aauer1/sam9g25/sam9g25.sch.pdf

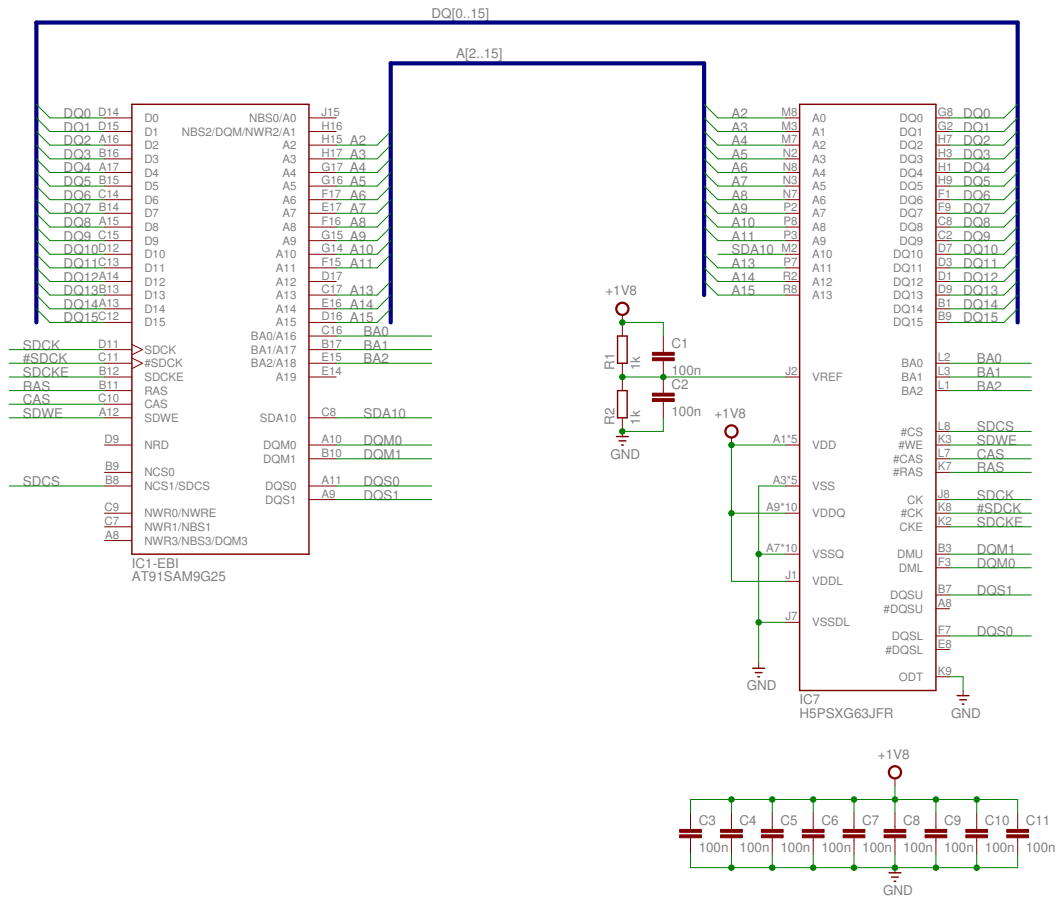
[picture p1: page 1]

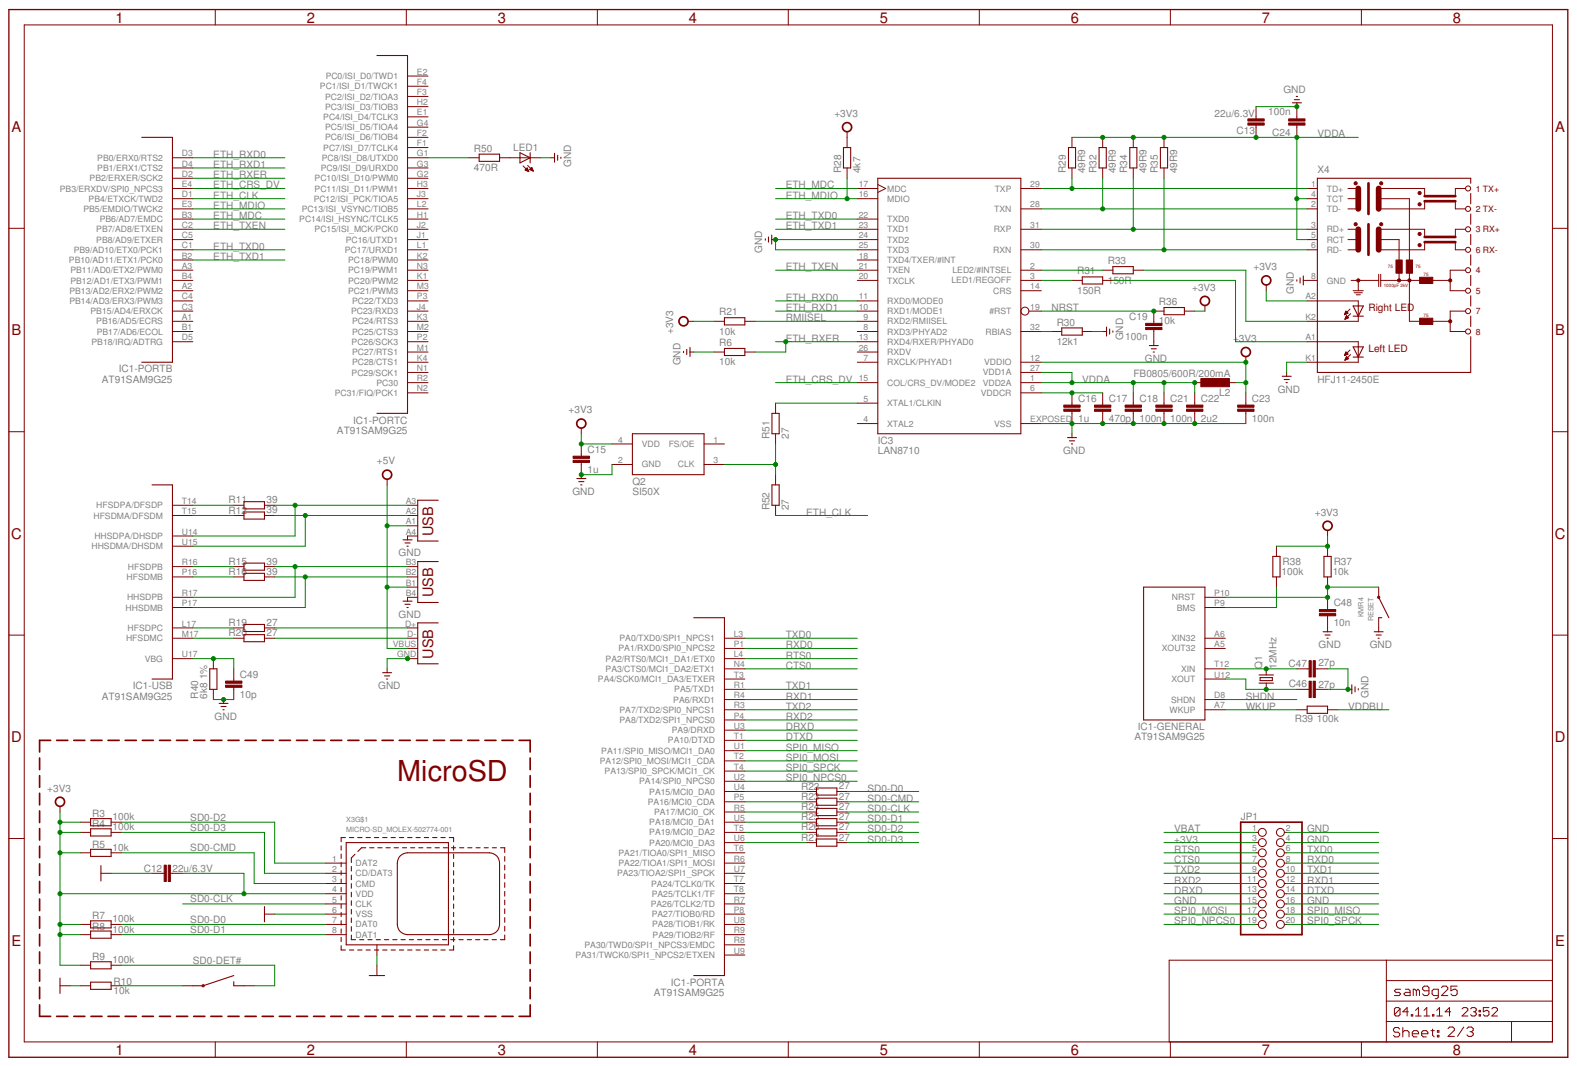
[picture p2: page 2]

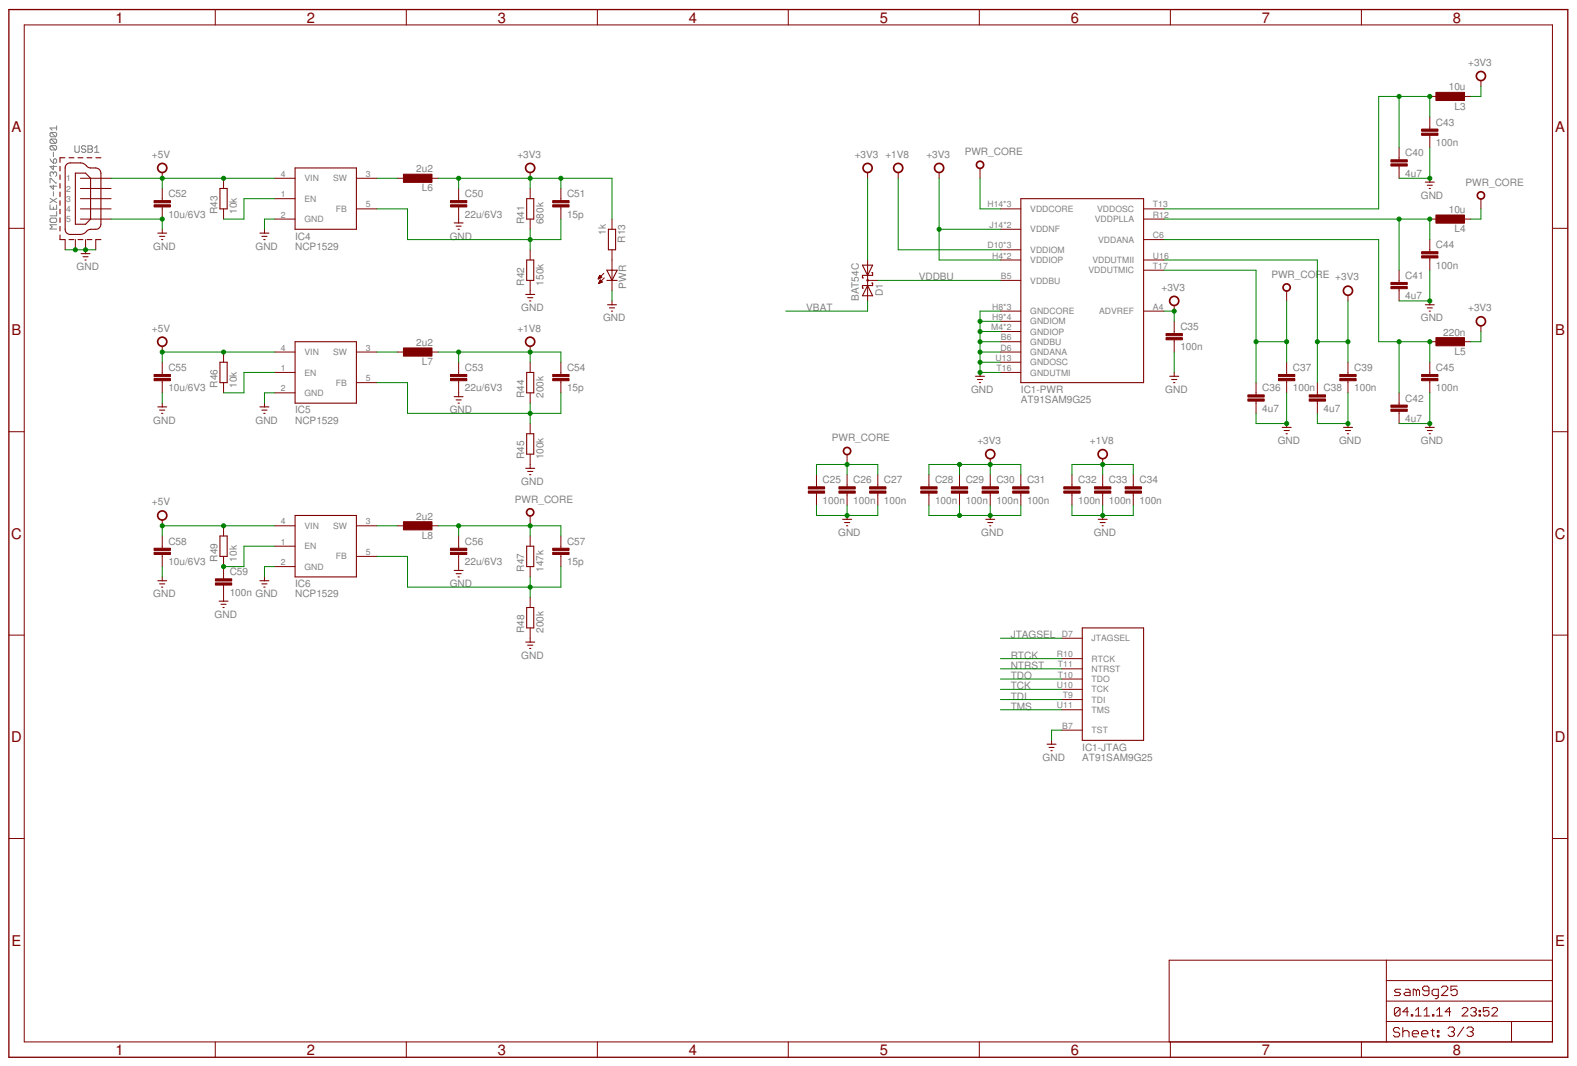
[picture p3: page 3]
