aauer1/sam9g25/sam9g25.brd

## EAGLE design sam9g25.brd (2015-02-23)

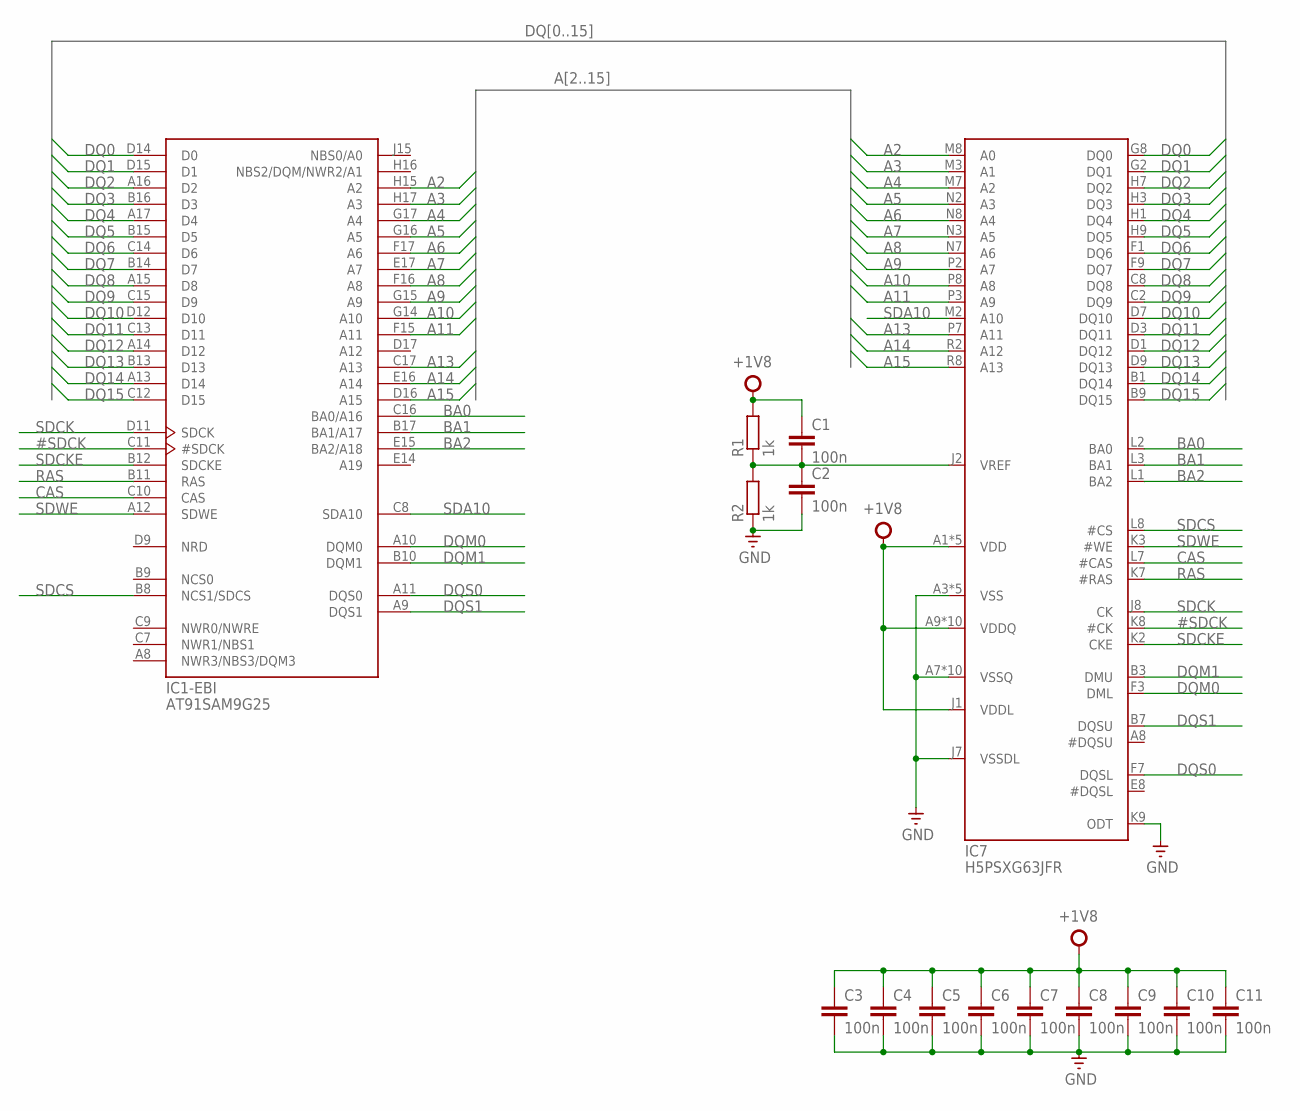
[picture p4: schematic sam9g25.sch, sheet 1]

Parts:
C1, C2, C3, C4, C5, C6, C7, C8, C9, C10, C11: 100n; C0603; MPN MC0603B104K250CT
IC1: AT91SAM9G25; LFBGA217; MPN AT91SAM9G25-CU
IC7: H5PSXG63JFR; FBGA84; MPN H5PS1G63JFR-S5C
R1, R2: 1k; R0603; MPN MC0063W060351K5

Connections:
#SDCK: IC1.C11 (#SDCK), IC7.K8 (#CK)
+1V8: C1.1, C3.1, C4.1, C5.1, C6.1, C7.1, C8.1, C9.1, C10.1, C11.1, IC7.A1 (VDD), IC7.A9 (VDDQ), IC7.C1 (VDDQ), IC7.C3 (VDDQ), IC7.C7 (VDDQ), IC7.C9 (VDDQ), IC7.E1 (VDD), IC7.E9 (VDDQ), IC7.G1 (VDDQ), IC7.G3 (VDDQ), IC7.G7 (VDDQ), IC7.G9 (VDDQ), IC7.J1 (VDDL), IC7.J9 (VDD), IC7.M9 (VDD), IC7.R1 (VDD), R1.2; also elsewhere on the board
A2: IC1.H15 (A2), IC7.M8 (A0)
A3: IC1.H17 (A3), IC7.M3 (A1)
A4: IC1.G17 (A4), IC7.M7 (A2)
A5: IC1.G16 (A5), IC7.N2 (A3)
A6: IC1.F17 (A6), IC7.N8 (A4)
A7: IC1.E17 (A7), IC7.N3 (A5)
A8: IC1.F16 (A8), IC7.N7 (A6)
A9: IC1.G15 (A9), IC7.P2 (A7)
A10: IC1.G14 (A10), IC7.P8 (A8)
A11: IC1.F15 (A11), IC7.P3 (A9)
A13: IC1.C17 (A13), IC7.P7 (A11)
A14: IC1.E16 (A14), IC7.R2 (A12)
A15: IC1.D16 (A15), IC7.R8 (A13)
BA0: IC1.C16 (BA0/A16), IC7.L2 (BA0)
BA1: IC1.B17 (BA1/A17), IC7.L3 (BA1)
BA2: IC1.E15 (BA2/A18), IC7.L1 (BA2)
CAS: IC1.C10 (CAS), IC7.L7 (#CAS)
DQ0: IC1.D14 (D0), IC7.G8 (DQ0)
DQ1: IC1.D15 (D1), IC7.G2 (DQ1)
DQ2: IC1.A16 (D2), IC7.H7 (DQ2)
DQ3: IC1.B16 (D3), IC7.H3 (DQ3)
DQ4: IC1.A17 (D4), IC7.H1 (DQ4)
DQ5: IC1.B15 (D5), IC7.H9 (DQ5)
DQ6: IC1.C14 (D6), IC7.F1 (DQ6)
DQ7: IC1.B14 (D7), IC7.F9 (DQ7)
DQ8: IC1.A15 (D8), IC7.C8 (DQ8)
DQ9: IC1.C15 (D9), IC7.C2 (DQ9)
DQ10: IC1.D12 (D10), IC7.D7 (DQ10)
DQ11: IC1.C13 (D11), IC7.D3 (DQ11)
DQ12: IC1.A14 (D12), IC7.D1 (DQ12)
DQ13: IC1.B13 (D13), IC7.D9 (DQ13)
DQ14: IC1.A13 (D14), IC7.B1 (DQ14)
DQ15: IC1.C12 (D15), IC7.B9 (DQ15)
DQM0: IC1.A10 (DQM0), IC7.F3 (DML)
DQM1: IC1.B10 (DQM1), IC7.B3 (DMU)
DQS0: IC1.A11 (DQS0), IC7.F7 (DQSL)
DQS1: IC1.A9 (DQS1), IC7.B7 (DQSU)
GND: C2.2, C3.2, C4.2, C5.2, C6.2, C7.2, C8.2, C9.2, C10.2, C11.2, IC7.A3 (VSS), IC7.A7 (VSSQ), IC7.B2 (VSSQ), IC7.B8 (VSSQ), IC7.D2 (VSSQ), IC7.D8 (VSSQ), IC7.E3 (VSS), IC7.E7 (VSSQ), IC7.F2 (VSSQ), IC7.F8 (VSSQ), IC7.H2 (VSSQ), IC7.H8 (VSSQ), IC7.J3 (VSS), IC7.J7 (VSSDL), IC7.K9 (ODT), IC7.N1 (VSS), IC7.P9 (VSS), R2.1; also elsewhere on the board
unnamed: C1.2, C2.1, IC7.J2 (VREF), R1.1, R2.2
RAS: IC1.B11 (RAS), IC7.K7 (#RAS)
SDA10: IC1.C8 (SDA10), IC7.M2 (A10)
SDCK: IC1.D11 (SDCK), IC7.J8 (CK)
SDCKE: IC1.B12 (SDCKE), IC7.K2 (CKE)
SDCS: IC1.B8 (NCS1/SDCS), IC7.L8 (#CS)
SDWE: IC1.A12 (SDWE), IC7.K3 (#WE)

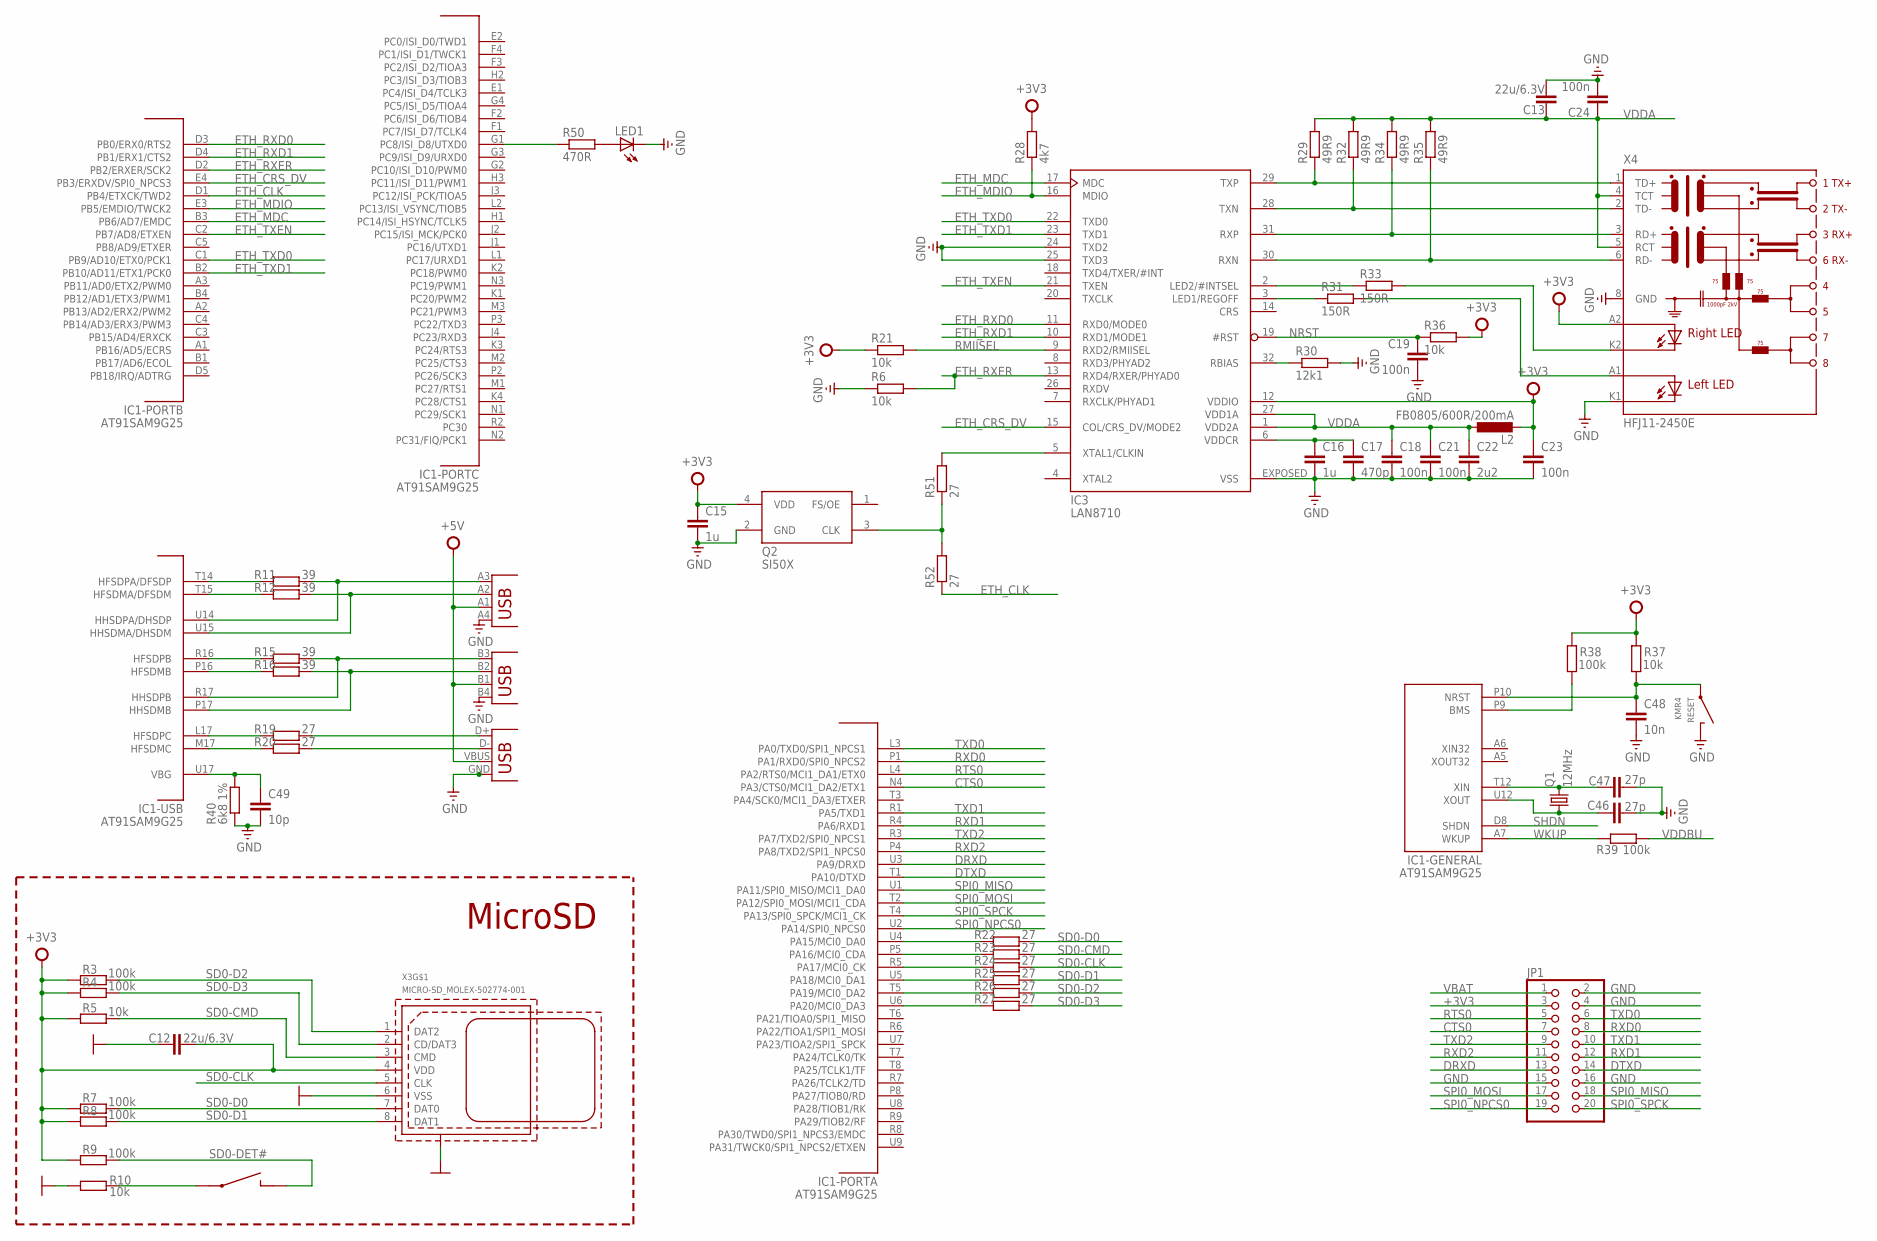
[picture p5: schematic sam9g25.sch, sheet 2]

Parts:
C12, C13: 22u/6.3V; C0805; MPN C2012X5R0J226M/1.25
C15: 1u; C0603; MPN MC0603N270J500CT
C16: 1u; C0603; MPN MC0603X105K100CT
C17: 470p; C0603; MPN MC0603B471K500CT
C18, C19, C21, C23, C24: 100n; C0603; MPN MC0603B104K250CT
C22: 2u2; C0603; MPN MC0603X225K6R3CT
C46, C47: 27p; C0603; MPN MC0603N270J500CT
C48: 10n; C0603; MPN MC0603B103K160CT
C49: 10p; C0603; MPN MC0603N100J500CT
IC1: AT91SAM9G25; LFBGA217; MPN AT91SAM9G25-CU
IC3: LAN8710; QFN32; MPN LAN8710A-EZK
JP1: PINHD-2X10; 2X10
L2: FB0805/600R/200mA; L2012C; MPN BLM21BD601SN1D
LED1: LEDCHIP-LED0603; CHIP-LED0603; MPN KP-1608SURCK
Q1: 12MHz; SMD5032; MPN 7A-12.000MAAJ-T
Q2: SI50X; DFN4
R3, R4, R7, R8, R9, R38, R39: 100k; R0603; MPN MC0063W06035100K
R5, R6, R10, R21, R37: 10k; R0603; MPN RC0603FR-0710KL
R11, R12, R15, R16: 39; R0603; MPN CRCW060339R0FKEA
R19, R20, R22, R23, R24, R25, R26, R27: 27; R0603; MPN MC0063W0603527R
R28: 4k7; R0603; MPN MC0063W060354K7
R29, R32, R34, R35: 49R9; R0603; MPN ERJ3GEYJ510V
R30: 12k1; R0603; MPN ERJ3EKF1212V
R31, R33: 150R; R0603; MPN MC0063W06035150R
R36: 10k; R0603; MPN ERJ3EKF1212V
R40: 6k8 1%; R0603; MPN MCMR06X6801FTL
R50: 470R; R0603; MPN MCMR06X1001FTL
R51, R52: 27; R0603; MPN RC0603FR-0710KL
RESET: KMR4; MPN KMR421NGULCLFS
X1: USB-DOUBLE; USB-DOUBLE-FCI; MPN 72309-8034BLF
X3: MICRO-SD_MOLEX-502774-001; MOLEX-MICRO-SD; MPN 502774-0891
X4: HFJ11-2450E; HFJ11_LED
X5: USB-A-HU

Connections:
+3V3: C12.2, C15.1, C23.1, IC3.12 (VDDIO), JP1.3, L2.2, Q2.4 (VDD), R3.2, R4.2, R5.2, R7.2, R8.2, R9.2, R21.1, R28.2, R36.2, R37.2, R38.2, X3.4 (VDD), X4.A2 (A-R); also elsewhere on the board
+5V: X1.A1 (VBUS), X1.B1 (VBUS), X5.VBUS; also elsewhere on the board
CTS0: IC1.N4 (PA3/CTS0/MCI1_DA2/ETX1), JP1.7
DRXD: IC1.U3 (PA9/DRXD), JP1.13
DTXD: IC1.T1 (PA10/DTXD), JP1.14
ETH_CLK: IC1.D1 (PB4/ETXCK/TWD2), R52.1
ETH_CRS_DV: IC1.E4 (PB3/ERXDV/SPI0_NPCS3), IC3.15 (COL/CRS_DV/MODE2)
ETH_MDC: IC1.B3 (PB6/AD7/EMDC), IC3.17 (MDC)
ETH_MDIO: IC1.E3 (PB5/EMDIO/TWCK2), IC3.16 (MDIO), R28.1
ETH_RXD0: IC1.D3 (PB0/ERX0/RTS2), IC3.11 (RXD0/MODE0)
ETH_RXD1: IC1.D4 (PB1/ERX1/CTS2), IC3.10 (RXD1/MODE1)
ETH_RXER: IC1.D2 (PB2/ERXER/SCK2), IC3.13 (RXD4/RXER/PHYAD0), R6.2
ETH_TXD0: IC1.C1 (PB9/AD10/ETX0/PCK1), IC3.22 (TXD0)
ETH_TXD1: IC1.B2 (PB10/AD11/ETX1/PCK0), IC3.23 (TXD1)
ETH_TXEN: IC1.C2 (PB7/AD8/ETXEN), IC3.21 (TXEN)
GND: C12.1, C13.2, C15.2, C16.2, C17.2, C18.2, C19.2, C21.2, C22.2, C23.2, C24.2, C46.2, C47.2, C48.2, C49.2, IC3.24 (TXD2), IC3.25 (TXD3), IC3.EXPOSED (VSS), JP1.2, JP1.4, JP1.15, JP1.16, LED1.C, Q2.2 (GND), R6.1, R10.2, R30.2, R40.1, RESET.2, RESET.4, X1.A4 (GND), X1.B4 (GND), X3.6 (VSS), X3.SHIELD@1, X3.SHIELD@2, X3.SHIELD@3, X3.SHIELD@4, X4.8 (GND), X4.K1 (C-L), X5.GND; also elsewhere on the board
HFSDMA: IC1.T15 (HFSDMA/DFSDM), R12.1
HFSDMB: IC1.P16 (HFSDMB), R16.1
HFSDMC: IC1.M17 (HFSDMC), R20.1
HFSDPA: IC1.T14 (HFSDPA/DFSDP), R11.1
HFSDPB: IC1.R16 (HFSDPB), R15.1
HFSDPC: IC1.L17 (HFSDPC), R19.1
HHSDMA: IC1.U15 (HHSDMA/DHSDM), R12.2, X1.A2 (D-)
HHSDMB: IC1.P17 (HHSDMB), R16.2, X1.B2 (D-)
HHSDPA: IC1.U14 (HHSDPA/DHSDP), R11.2, X1.A3 (D+)
HHSDPB: IC1.R17 (HHSDPB), R15.2, X1.B3 (D+)
unnamed: IC3.5 (XTAL1/CLKIN), R51.2
unnamed: R19.2, X5.D+
unnamed: R20.2, X5.D-
unnamed: IC1.U6 (PA20/MCI0_DA3), R27.1
unnamed: IC1.T5 (PA19/MCI0_DA2), R26.1
unnamed: IC1.U5 (PA18/MCI0_DA1), R25.1
unnamed: IC1.R5 (PA17/MCI0_CK), R24.1
unnamed: IC1.P5 (PA16/MCI0_CDA), R23.1
unnamed: IC1.U4 (PA15/MCI0_DA0), R22.1
unnamed: C49.1, IC1.U17 (VBG), R40.2
unnamed: C46.1, IC1.U12 (XOUT), Q1.1
unnamed: C47.1, IC1.T12 (XIN), Q1.2
unnamed: IC1.P9 (BMS), R38.1
unnamed: IC3.32 (RBIAS), R30.1
unnamed: C16.1, C17.1, IC3.6 (VDDCR)
unnamed: IC1.G1 (PC8/ISI_D8/UTXD0), R50.1
unnamed: LED1.A, R50.2
unnamed: Q2.3 (CLK), R51.1, R52.2
unnamed: R10.1, X3.SW1
unnamed: IC3.2 (LED2/#INTSEL), R33.1
unnamed: IC3.3 (LED1/REGOFF), R31.1
unnamed: IC3.30 (RXN), R35.1, X4.6 (RD-)
unnamed: IC3.31 (RXP), R34.1, X4.3 (RD+)
unnamed: IC3.29 (TXP), R29.1, X4.1 (TD+)
unnamed: R33.2, X4.K2 (C-R)
unnamed: R31.2, X4.A1 (A-L)
unnamed: IC3.28 (TXN), R32.1, X4.2 (TD-)
NRST: C19.1, C48.1, IC1.P10 (NRST), IC3.19 (#RST), R36.1, R37.1, RESET.1, RESET.3
RMIISEL: IC3.9 (RXD2/RMIISEL), R21.2
RTS0: IC1.L4 (PA2/RTS0/MCI1_DA1/ETX0), JP1.5
RXD0: IC1.P1 (PA1/RXD0/SPI0_NPCS2), JP1.8
RXD1: IC1.R4 (PA6/RXD1), JP1.12
RXD2: IC1.P4 (PA8/TXD2/SPI1_NPCS0), JP1.11
SD0-CLK: R24.2, X3.5 (CLK)
SD0-CMD: R5.1, R23.2, X3.3 (CMD)
SD0-D0: R7.1, R22.2, X3.7 (DAT0)
SD0-D1: R8.1, R25.2, X3.8 (DAT1)
SD0-D2: R3.1, R26.2, X3.1 (DAT2)
SD0-D3: R4.1, R27.2, X3.2 (CD/DAT3)
SD0-DET#: R9.1, X3.SW2
SHDN: IC1.D8 (SHDN)
SPI0_MISO: IC1.U1 (PA11/SPI0_MISO/MCI1_DA0), JP1.18
SPI0_MOSI: IC1.T2 (PA12/SPI0_MOSI/MCI1_CDA), JP1.17
SPI0_NPCS0: IC1.U2 (PA14/SPI0_NPCS0), JP1.19
SPI0_SPCK: IC1.T4 (PA13/SPI0_SPCK/MCI1_CK), JP1.20
TXD0: IC1.L3 (PA0/TXD0/SPI1_NPCS1), JP1.6
TXD1: IC1.R1 (PA5/TXD1), JP1.10
TXD2: IC1.R3 (PA7/TXD2/SPI0_NPCS1), JP1.9
VBAT: JP1.1; also elsewhere on the board
VDDA: C13.1, C18.1, C21.1, C22.1, C24.1, IC3.1 (VDD2A), IC3.27 (VDD1A), L2.1, R29.2, R32.2, R34.2, R35.2, X4.4 (TCT), X4.5 (RCT)
VDDBU: R39.1; also elsewhere on the board
WKUP: IC1.A7 (WKUP), R39.2

Notes on the sheet:
MicroSD

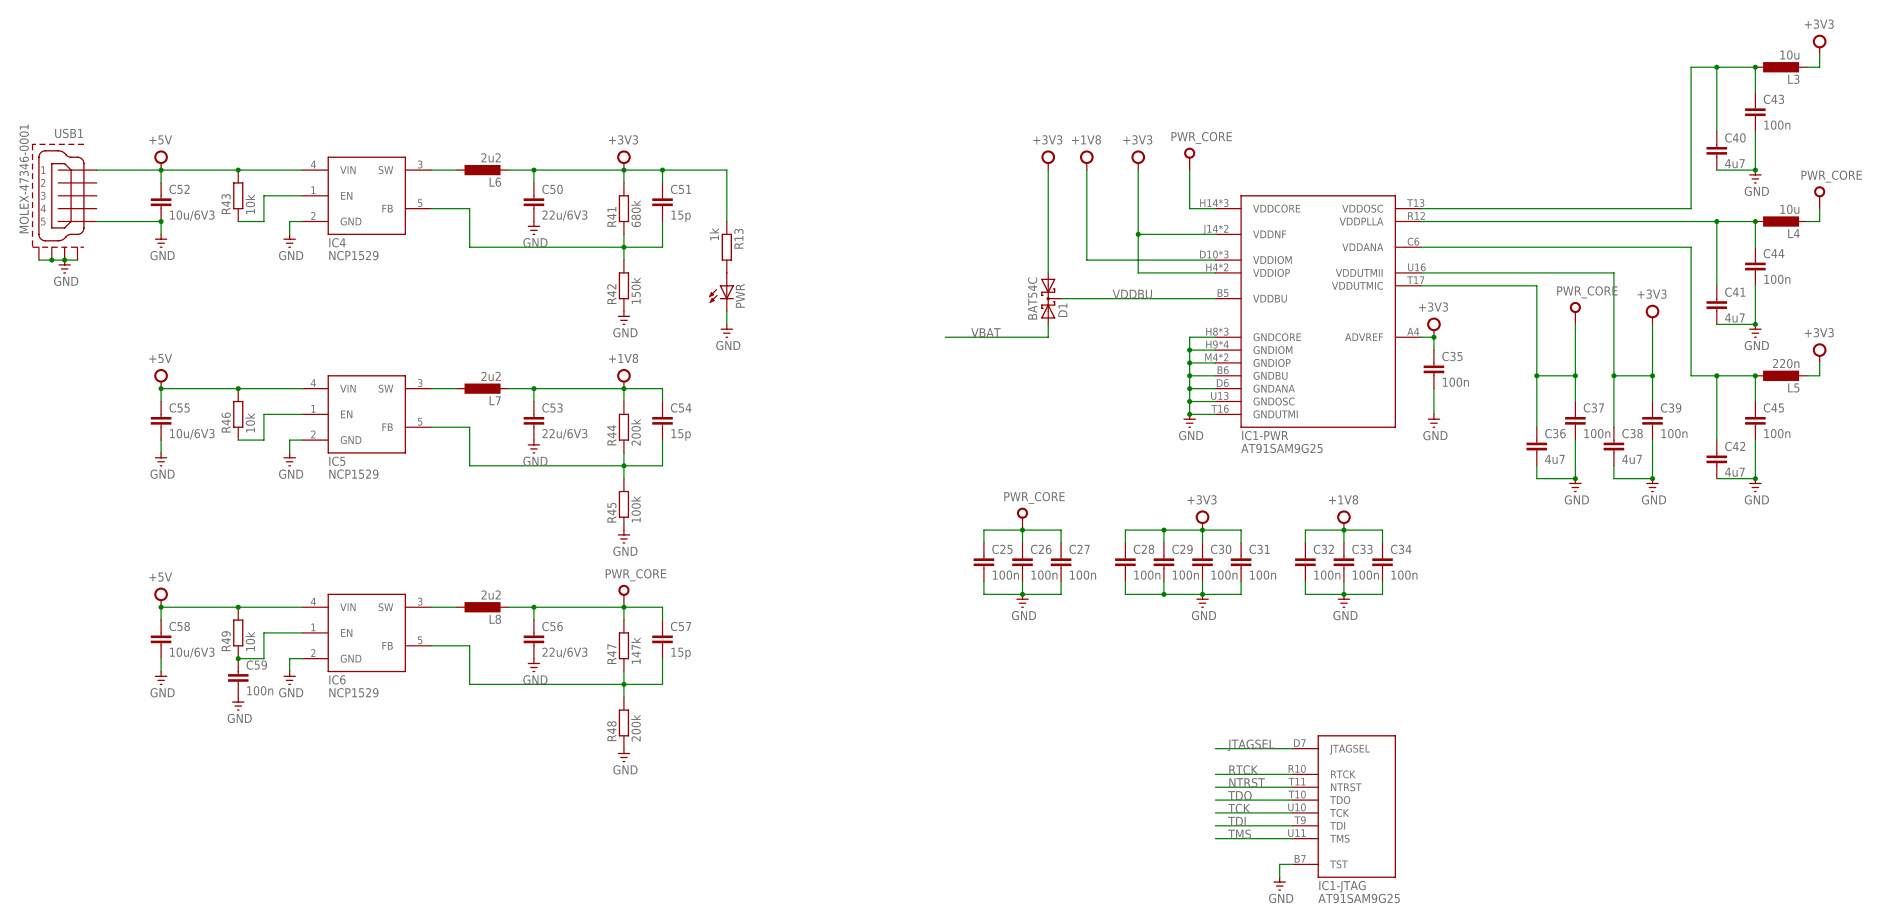
[picture p6: schematic sam9g25.sch, sheet 3]

Parts:
C25, C26, C27, C28, C29, C30, C31, C32, C33, C34, C35, C37, C39, C43, C44, C45, C59: 100n; C0603; MPN MC0603B104K250CT
C36, C38, C40, C41, C42: 4u7; C0603; MPN MC0603X475K6R3CT
C50, C53, C56: 22u/6V3; C0805; MPN MC0805X106K6R3CT
C51, C54, C57: 15p; C0603; MPN MC0603N150J500CT
C52, C55, C58: 10u/6V3; C0805; MPN MC0805X106K6R3CT
D1: BAT54C; SOT23; MPN BAT54C
IC1: AT91SAM9G25; LFBGA217; MPN AT91SAM9G25-CU
IC4, IC5, IC6: NCP1529; SOT23-5; MPN NCP1529ASNT1G
L3, L4: 10u; L2012C; MPN CB2012T100MR.
L5: 220n; L2012C; MPN MLZ2012DR22DT
L6, L7, L8: 2u2; L3230M; MPN ME3220-222MLB
PWR: LEDCHIP-LED0603; CHIP-LED0603; MPN KP-1608SURCK
R13: 1k; R0603; MPN MCMR06X1001FTL
R41: 680k; R0603; MPN CRCW0603680KFKEA
R42: 150k; R0603; MPN ERJ3GEYJ154V
R43, R46, R49: 10k; R0603; MPN RC0603FR-0710KL
R44, R48: 200k; R0603; MPN ERJ3EKF2003V
R45: 100k; R0603; MPN MC0063W06035100K
R47: 147k; R0603; MPN CRCW0603147KFKEA
USB1: MOLEX-47346-0001; MOLEX-47364-0001; MPN 47346-0001

Connections:
+1V8: C32.1, C33.1, C34.1, C53.1, C54.1, IC1.D10 (VDDIOM), IC1.D13 (VDDIOM), IC1.F14 (VDDIOM), L7.2, R44.2; also elsewhere on the board
+3V3: C28.1, C29.1, C30.1, C31.1, C35.1, C38.1, C39.1, C50.1, C51.1, D1.1 (A1), IC1.A4 (ADVREF), IC1.H4 (VDDIOP), IC1.J14 (VDDNF), IC1.K14 (VDDNF), IC1.P7 (VDDIOP), IC1.U16 (VDDUTMII), L3.2, L5.2, L6.2, R13.1, R41.2; also elsewhere on the board
+5V: C52.1, C55.1, C58.1, IC4.4 (VIN), IC5.4 (VIN), IC6.4 (VIN), R43.2, R46.2, R49.2, USB1.1; also elsewhere on the board
GND: C25.2, C26.2, C27.2, C28.2, C29.2, C30.2, C31.2, C32.2, C33.2, C34.2, C35.2, C36.2, C37.2, C38.2, C39.2, C40.2, C41.2, C42.2, C43.2, C44.2, C45.2, C50.2, C52.2, C53.2, C55.2, C56.2, C58.2, C59.2, IC1.B6 (GNDBU), IC1.B7 (TST), IC1.D6 (GNDANA), IC1.H8 (GNDCORE), IC1.H9 (GNDIOM), IC1.H10 (GNDIOM), IC1.J8 (GNDCORE), IC1.J9 (GNDIOM), IC1.J10 (GNDIOM), IC1.K10 (GNDCORE), IC1.M4 (GNDIOP), IC1.P6 (GNDIOP), IC1.T16 (GNDUTMI), IC1.U13 (GNDOSC), IC4.2 (GND), IC5.2 (GND), IC6.2 (GND), PWR.C, R42.1, R45.1, R48.1, USB1.5, USB1.GND1, USB1.GND2, USB1.GND3, USB1.GND4; also elsewhere on the board
JTAGSEL: IC1.D7 (JTAGSEL)
unnamed: PWR.A, R13.2
unnamed: IC4.3 (SW), L6.1
unnamed: IC5.3 (SW), L7.1
unnamed: C51.2, IC4.5 (FB), R41.1, R42.2
unnamed: C54.2, IC5.5 (FB), R44.1, R45.2
unnamed: IC4.1 (EN), R43.1
unnamed: IC5.1 (EN), R46.1
unnamed: IC6.3 (SW), L8.1
unnamed: C57.2, IC6.5 (FB), R47.1, R48.2
unnamed: C59.1, IC6.1 (EN), R49.1
NTRST: IC1.T11 (NTRST)
PWR_CORE: C25.1, C26.1, C27.1, C36.1, C37.1, C56.1, C57.1, IC1.H14 (VDDCORE), IC1.K8 (VDDCORE), IC1.K9 (VDDCORE), IC1.T17 (VDDUTMIC), L4.2, L8.2, R47.2
RTCK: IC1.R10 (RTCK)
TCK: IC1.U10 (TCK)
TDI: IC1.T9 (TDI)
TDO: IC1.T10 (TDO)
TMS: IC1.U11 (TMS)
VBAT: D1.2 (A2); also elsewhere on the board
VDDANA: C42.1, C45.1, IC1.C6 (VDDANA), L5.1
VDDBU: D1.3 (CC), IC1.B5 (VDDBU); also elsewhere on the board
VDDOSC: C40.1, C43.1, IC1.T13 (VDDOSC), L3.1
VDDPLLA: C41.1, C44.1, IC1.R12 (VDDPLLA), L4.1

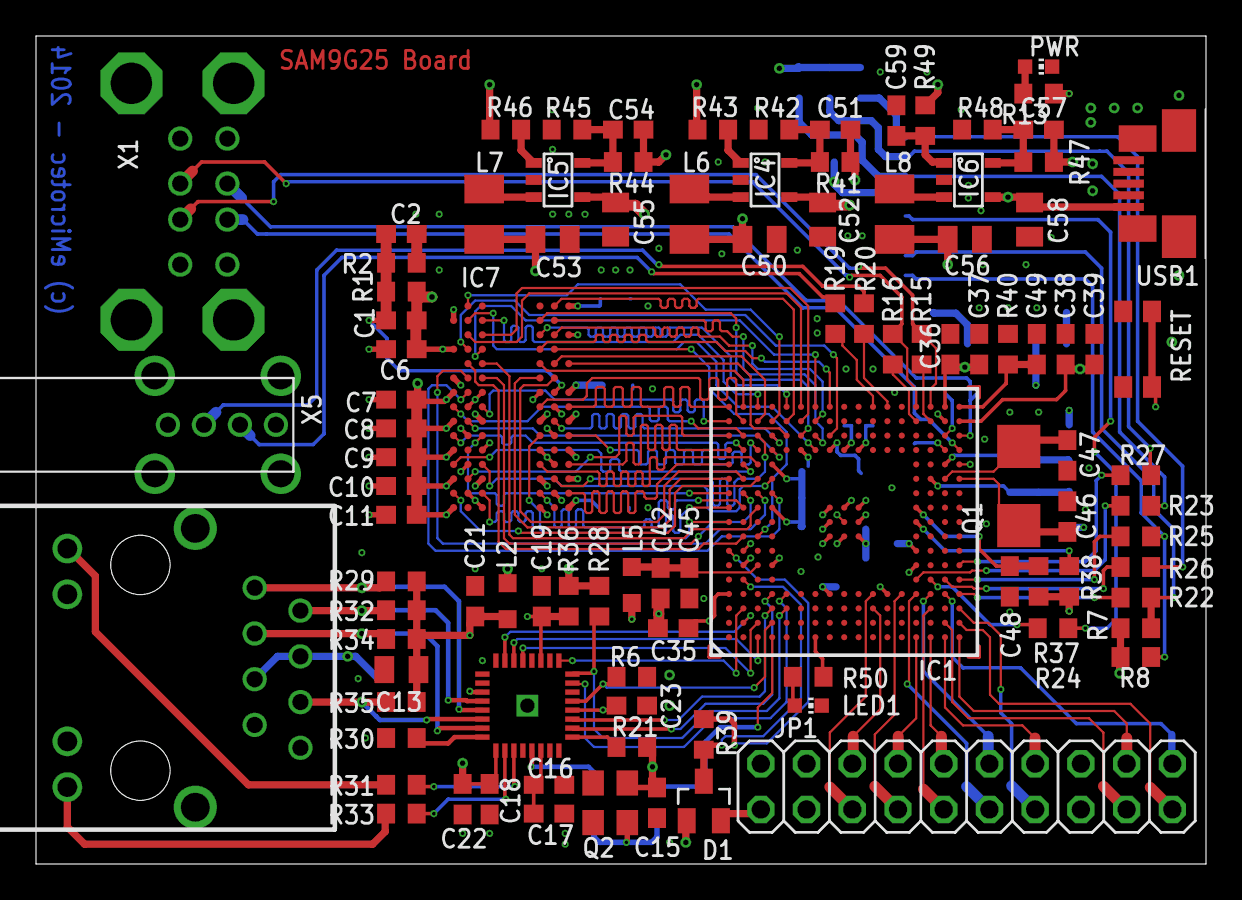
[picture p7: board sam9g25.brd from above]

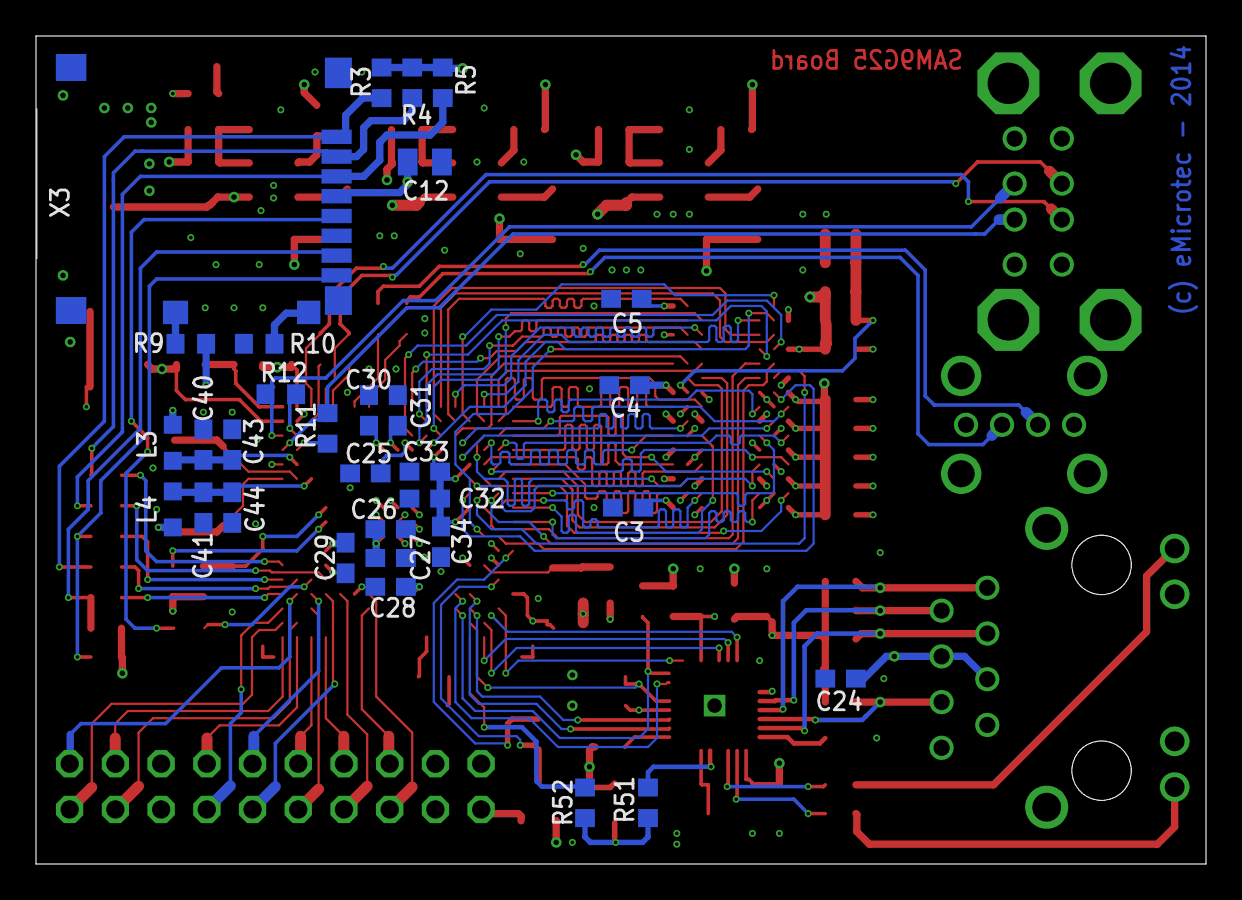
[picture p8: board sam9g25.brd from below]

Board: 4 copper layers, 65.0 x 46.0 mm, 131 parts (31 on the bottom side), 137 nets.
