aauer1/sam9g25/(commit log)

2014-10-15 First version, but with ethernet refclk hardware bug
    [bom.ods, bom_parts.ods, sam9g25.brd, sam9g25.sch]
2015-02-23 Fixed ethernet refclk hardware bug Fixed usb ports
    [bom.ods, bom_parts.ods, sam9g25.brd, sam9g25.sch]
2015-02-23 GNU GPL V2 licence added to schematics and board file
    [sam9g25.brd, sam9g25.sch]
