aauer1/sam9g25/(notices)

Notices in the files:
sam9g25.sch:
Copyright (C) 2015 Andreas Auer (aauer1@emicrotec.at)
This program is free software; you can redistribute it and/or modify
it under the terms of the GNU General Public License as published by
the Free Software Foundation; either version 2 of the License, or
(at your option) any later version.
